Shark17e/M5DinMeter-KilnController/docs/images/confirm_delete.png

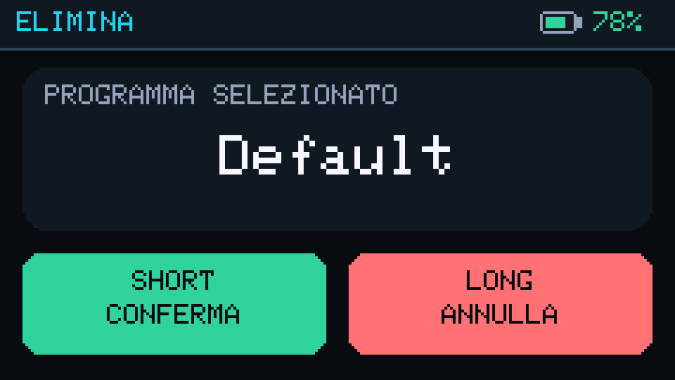
docs/images/confirm_delete.png
