Shark17e/M5DinMeter-KilnController/docs/images/new_name.png

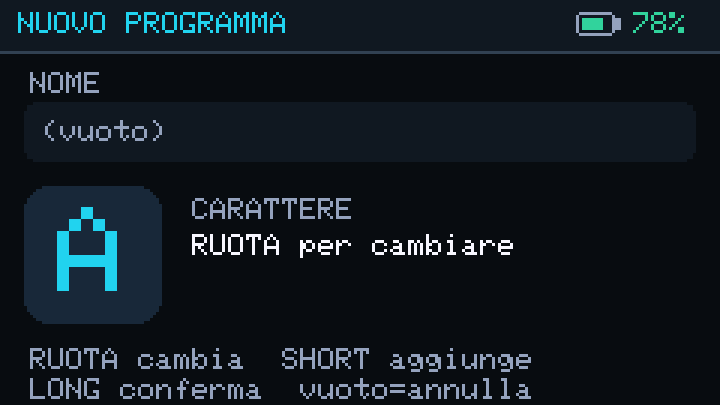
docs/images/new_name.png
