Shark17e/M5DinMeter-KilnController/docs/images/overtemp.png

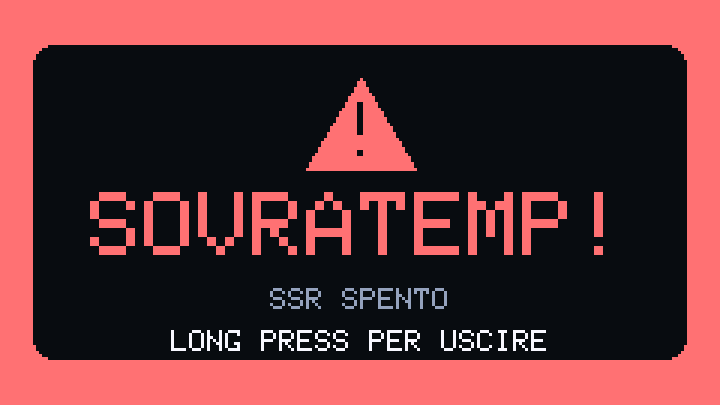
docs/images/overtemp.png
