Shark17e/M5DinMeter-KilnController/(commit log)

2026-08-07 fix: non ridisegnare RUNNING dopo attivazione SLOW_RISE in updateProgram
    [M5StackDin_KilnController.ino]
2026-08-07 fix: Attendi arrivo non termina piu' la cottura e etichetta step coerente durante l'attesa
    [M5StackDin_KilnController.ino, kiln_programs.ino, kiln_run.ino]
2026-08-08 feat: avvio senza sensore (menu invece di blocco) e modalita' manuale SSR
2026-11-09 feat: battery curve LiPo reale, refresh periodico e testi salita lenta
2026-11-09 fix: preserva i guadagni PID al salvataggio programmi e blocca nomi vuoti
2026-11-09 feat: icona di allarme nella schermata salita lenta
